DIY-Nabra/GrassiOsc-DIY/assets/mainboard_back.png

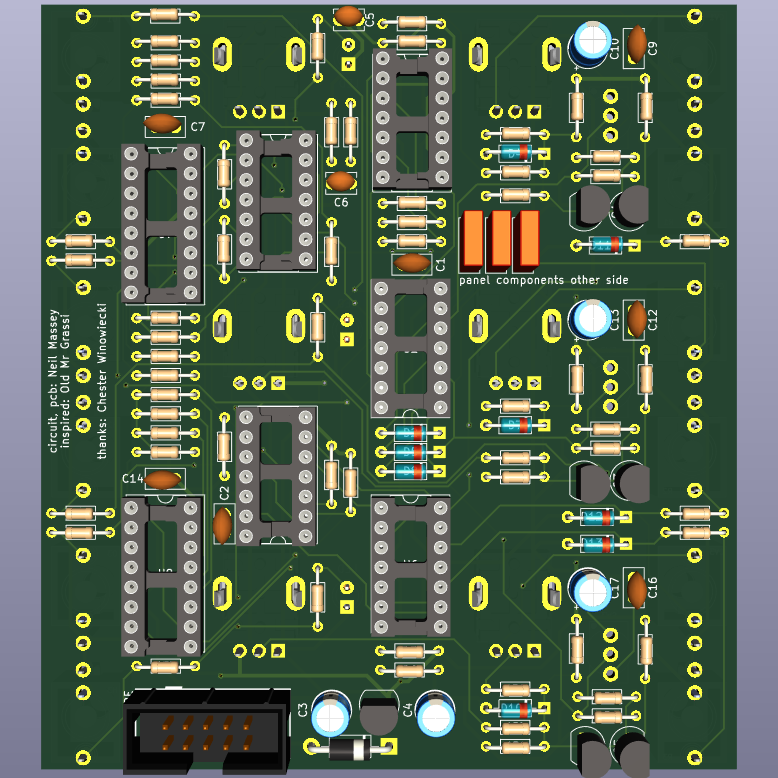
assets/mainboard_back.png
