DIY-Nabra/GrassiOsc-DIY/assets/alt-panel.png

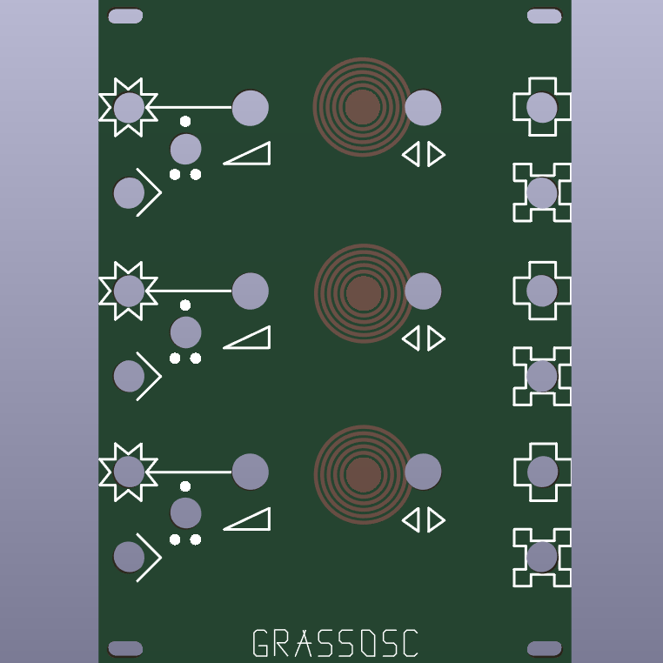
assets/alt-panel.png
