DIY-Nabra/GrassiOsc-DIY/assets/mainboard_front.png

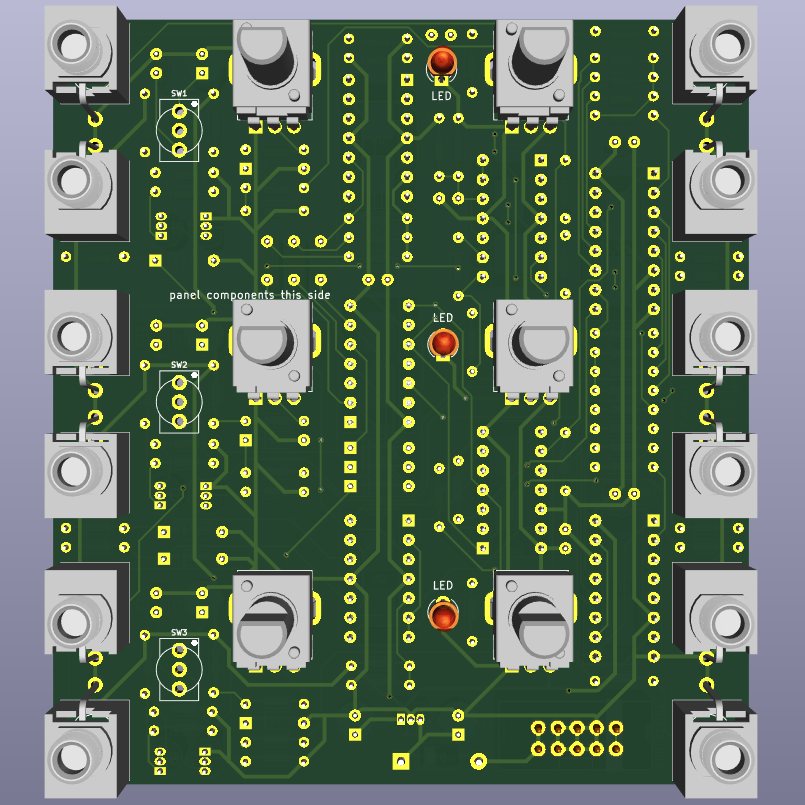
assets/mainboard_front.png
