DIY-Nabra/GrassiOsc-DIY/vector/mainboard-User_2.dxf

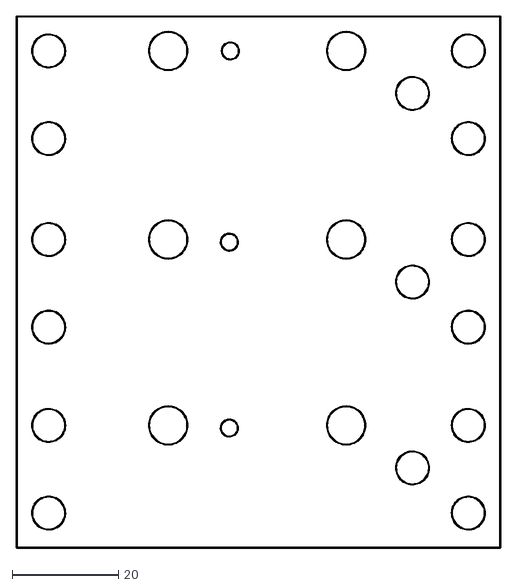
[picture p4: CAD file, 2022-08-26]
vector/mainboard-User_2.dxf
91.2 x 100.2
