DIY-Nabra/GrassiOsc-DIY/mainboard/mainboard.kicad_pcb

## KiCad design mainboard/mainboard.kicad_pcb (2022-09-11)

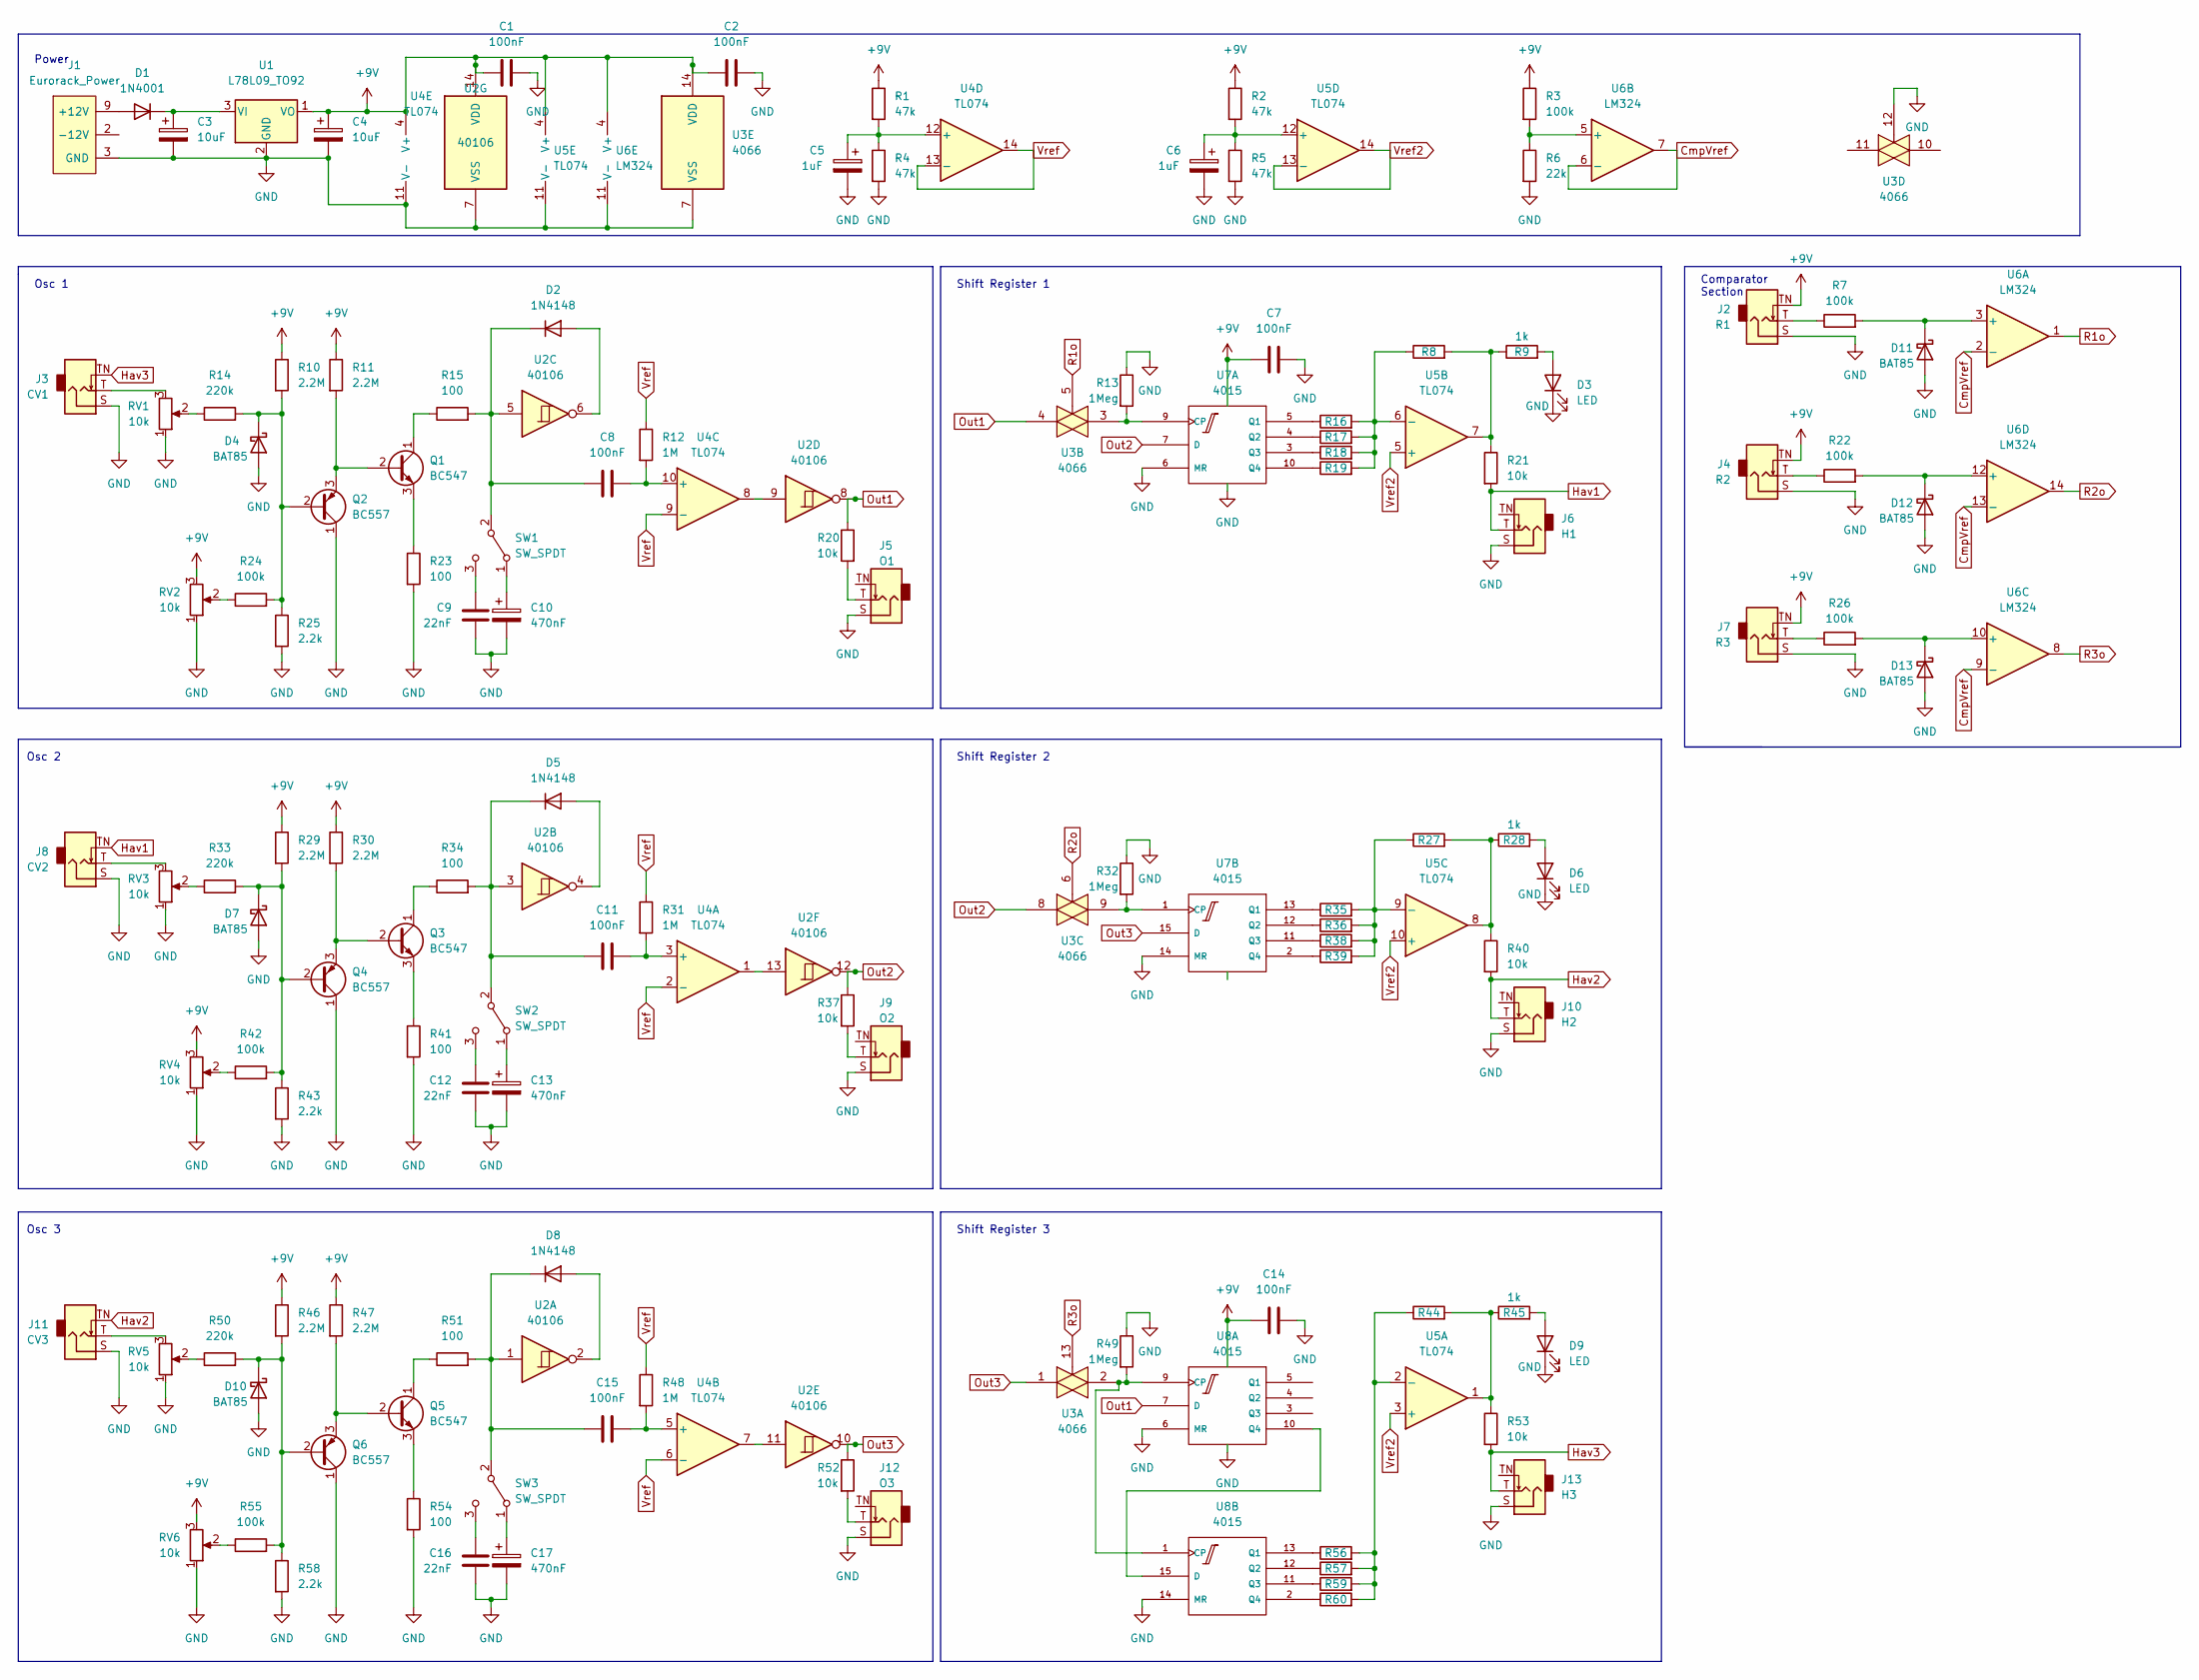
[picture p5: schematic mainboard.kicad_sch, GrassiOsc]

Parts:
C1, C2, C7, C14: 100nF; C_Disc_D5.0mm_W2.5mm_P2.50mm
C3, C4: 10uF; CP_Radial_D5.0mm_P2.50mm
C5, C6: 1uF; C_Disc_D3.8mm_W2.6mm_P2.50mm
C8, C11, C15: 100nF; C_Rect_L7.0mm_W2.5mm_P5.00mm
C9, C12, C16: 22nF; C_Disc_D5.0mm_W2.5mm_P2.50mm
C10, C13, C17: 470nF; CP_Radial_D5.0mm_P2.50mm
D1: 1N4001; D_DO-41_SOD81_P10.16mm_Horizontal
D2, D5, D8: 1N4148; D_DO-35_SOD27_P7.62mm_Horizontal
D3, D6, D9: LED; LED_D3.0mm
D4, D7, D10, D11, D12, D13: BAT85; D_DO-35_SOD27_P7.62mm_Horizontal
J1: Eurorack_Power; Eurorack_Power_2x5_Shrouded; mpn 302-S101
J2: R1; AudioJack_WQP518MA
J3: CV1; AudioJack_WQP518MA
J4: R2; AudioJack_WQP518MA
J5: O1; AudioJack_WQP518MA
J6: H1; AudioJack_WQP518MA
J7: R3; AudioJack_WQP518MA
J8: CV2; AudioJack_WQP518MA
J9: O2; AudioJack_WQP518MA
J10: H2; AudioJack_WQP518MA
J11: CV3; AudioJack_WQP518MA
J12: O3; AudioJack_WQP518MA
J13: H3; AudioJack_WQP518MA
Q1, Q3, Q5: BC547; TO-92_Inline
Q2, Q4, Q6: BC557; TO-92_Inline
R1, R2, R4, R5: 47k; R_Axial_DIN0204_L3.6mm_D1.6mm_P7.62mm_Horizontal
R3, R7, R22, R24, R26, R42, R55: 100k; R_Axial_DIN0204_L3.6mm_D1.6mm_P7.62mm_Horizontal
R6: 22k; R_Axial_DIN0204_L3.6mm_D1.6mm_P7.62mm_Horizontal
R8, R16, R17, R18, R19, R27, R35, R36, R38, R39, R44, R56, R57, R59, R60: R; R_Axial_DIN0204_L3.6mm_D1.6mm_P7.62mm_Horizontal
R9, R28, R45: 1k; R_Axial_DIN0204_L3.6mm_D1.6mm_P7.62mm_Horizontal
R10, R11, R29, R30, R46, R47: 2.2M; R_Axial_DIN0204_L3.6mm_D1.6mm_P7.62mm_Horizontal
R12, R31, R48: 1M; R_Axial_DIN0204_L3.6mm_D1.6mm_P7.62mm_Horizontal
R13, R32, R49: 1Meg; R_Axial_DIN0204_L3.6mm_D1.6mm_P7.62mm_Horizontal
R14, R33, R50: 220k; R_Axial_DIN0204_L3.6mm_D1.6mm_P7.62mm_Horizontal
R15, R23, R34, R41, R51, R54: 100; R_Axial_DIN0204_L3.6mm_D1.6mm_P7.62mm_Horizontal
R20, R21, R37, R40, R52, R53: 10k; R_Axial_DIN0204_L3.6mm_D1.6mm_P7.62mm_Horizontal
R25, R43, R58: 2.2k; R_Axial_DIN0204_L3.6mm_D1.6mm_P7.62mm_Horizontal
RV1, RV2, RV3, RV4, RV5, RV6: 10k; Potentiometer_Alpha_R0904N
SW1, SW2, SW3: SW_SPDT; Miniature_Switch_SPDT_2.54MM
U1: L78L09_TO92; TO-92_Inline
U2: 40106; DIP-14_W7.62mm_Socket
U3: 4066; DIP-14_W7.62mm_Socket
U4, U5: TL074; DIP-14_W7.62mm_Socket
U6: LM324; DIP-14_W7.62mm_Socket
U7, U8: 4015; DIP-16_W7.62mm_Socket

Connections:
+9V: C1.1, C2.1, C4.1, C7.1, C14.1, J2.TN, J4.TN, J7.TN, R1.1, R2.1, R3.1, R10.1, R11.1, R29.1, R30.1, R46.1, R47.1, RV2.3, RV4.3, RV6.3, U1.1 (VO), U2.14 (VDD), U3.14 (VDD), U4.4 (V+), U5.4 (V+), U6.4 (V+), U7.16 (Vdd), U8.16 (Vdd)
CmpVref: U6.2 (-), U6.6 (-), U6.7, U6.9 (-), U6.13 (-)
GND: C1.2, C2.2, C3.2, C4.2, C5.2, C6.2, C7.2, C9.1, C10.2, C12.1, C13.2, C14.2, C16.1, C17.2, D3.1 (K), D4.2 (A), D6.1 (K), D7.2 (A), D9.1 (K), D10.2 (A), D11.2 (A), D12.2 (A), D13.2 (A), J1.3 (GND), J1.4 (GND), J1.5 (GND), J1.6 (GND), J1.7 (GND), J1.8 (GND), J2.S, J3.S, J4.S, J5.S, J6.S, J7.S, J8.S, J9.S, J10.S, J11.S, J12.S, J13.S, Q2.1 (C), Q4.1 (C), Q6.1 (C), R4.2, R5.2, R6.2, R13.1, R23.2, R25.2, R32.1, R41.2, R43.2, R49.1, R54.2, R58.2, RV1.1, RV2.1, RV3.1, RV4.1, RV5.1, RV6.1, U1.2 (GND), U2.7 (VSS), U3.7 (VSS), U3.12, U4.11 (V-), U5.11 (V-), U6.11 (V-), U7.6 (MR), U7.8 (Vss), U7.14 (MR), U8.6 (MR), U8.8 (Vss), U8.14 (MR)
Hav1: J6.T, J8.TN, R21.2
Hav2: J10.T, J11.TN, R40.2
Hav3: J3.TN, J13.T, R53.2
unnamed: C3.1, D1.1 (K), U1.3 (VI)
unnamed: C5.1, R1.2, R4.1, U4.12 (+)
unnamed: C6.1, R2.2, R5.1, U5.12 (+)
unnamed: C8.1, D2.1 (K), R15.2, SW1.2 (B), U2.5
unnamed: C8.2, R12.2, U4.10 (+)
unnamed: C9.2, SW1.3 (C)
unnamed: C10.1, SW1.1 (A)
unnamed: C11.1, D5.1 (K), R34.2, SW2.2 (B), U2.3
unnamed: C11.2, R31.2, U4.3 (+)
unnamed: C12.2, SW2.3 (C)
unnamed: C13.1, SW2.1 (A)
unnamed: C15.1, D8.1 (K), R51.2, SW3.2 (B), U2.1
unnamed: C15.2, R48.2, U4.5 (+)
unnamed: C16.2, SW3.3 (C)
unnamed: C17.1, SW3.1 (A)
unnamed: D1.2 (A), J1.9 (+12V), J1.10 (+12V)
unnamed: D2.2 (A), U2.6
unnamed: D3.2 (A), R9.2
unnamed: D4.1 (K), Q2.2 (B), R10.2, R14.2, R24.2, R25.1
unnamed: D5.2 (A), U2.4
unnamed: D6.2 (A), R28.2
unnamed: D7.1 (K), Q4.2 (B), R29.2, R33.2, R42.2, R43.1
unnamed: D8.2 (A), U2.2
unnamed: D9.2 (A), R45.2
unnamed: D10.1 (K), Q6.2 (B), R46.2, R50.2, R55.2, R58.1
unnamed: D11.1 (K), R7.2, U6.3 (+)
unnamed: D12.1 (K), R22.2, U6.12 (+)
unnamed: D13.1 (K), R26.2, U6.10 (+)
unnamed: J1.1 (-12V), J1.2 (-12V)
unnamed: J2.T, R7.1
unnamed: J3.T, RV1.3
unnamed: J4.T, R22.1
unnamed: J5.T, R20.2
unnamed: J7.T, R26.1
unnamed: J8.T, RV3.3
unnamed: J9.T, R37.2
unnamed: J11.T, RV5.3
unnamed: J12.T, R52.2
unnamed: Q1.1 (C), R15.1
unnamed: Q1.2 (B), Q2.3 (E), R11.2
unnamed: Q1.3 (E), R23.1
unnamed: Q3.1 (C), R34.1
unnamed: Q3.2 (B), Q4.3 (E), R30.2
unnamed: Q3.3 (E), R41.1
unnamed: Q5.1 (C), R51.1
unnamed: Q5.2 (B), Q6.3 (E), R47.2
unnamed: Q5.3 (E), R54.1
unnamed: R3.2, R6.1, U6.5 (+)
unnamed: R13.2, U3.3, U7.9 (CP)
unnamed: R14.1, RV1.2
unnamed: R16.1, U7.5 (Q1)
unnamed: R8.1, R16.2, R17.2, R18.2, R19.2, U5.6 (-)
unnamed: R17.1, U7.4 (Q2)
unnamed: R18.1, U7.3 (Q3)
unnamed: R19.1, U7.10 (Q4)
unnamed: R8.2, R9.1, R21.1, U5.7
unnamed: R24.1, RV2.2
unnamed: R27.1, R35.2, R36.2, R38.2, R39.2, U5.9 (-)
unnamed: R27.2, R28.1, R40.1, U5.8
unnamed: R32.2, U3.9, U7.1 (CP)
unnamed: R33.1, RV3.2
unnamed: R35.1, U7.13 (Q1)
unnamed: R36.1, U7.12 (Q2)
unnamed: R38.1, U7.11 (Q3)
unnamed: R39.1, U7.2 (Q4)
unnamed: R42.1, RV4.2
unnamed: R44.1, R56.2, R57.2, R59.2, R60.2, U5.2 (-)
unnamed: R44.2, R45.1, R53.1, U5.1
unnamed: R49.2, U3.2, U8.1 (CP), U8.9 (CP)
unnamed: R50.1, RV5.2
unnamed: R55.1, RV6.2
unnamed: R56.1, U8.13 (Q1)
unnamed: R57.1, U8.12 (Q2)
unnamed: R59.1, U8.11 (Q3)
unnamed: R60.1, U8.2 (Q4)
unnamed: U2.9, U4.8
unnamed: U2.11, U4.7
unnamed: U2.13, U4.1
unnamed: U8.10 (Q4), U8.15 (D)
Out1: R20.1, U2.8, U3.4, U8.7 (D)
Out2: R37.1, U2.12, U3.8, U7.7 (D)
Out3: R52.1, U2.10, U3.1, U7.15 (D)
R1o: U3.5, U6.1
R2o: U3.6, U6.14
R3o: U3.13, U6.8
Vref: R12.1, R31.1, R48.1, U4.2 (-), U4.6 (-), U4.9 (-), U4.13 (-), U4.14
Vref2: U5.3 (+), U5.5 (+), U5.10 (+), U5.13 (-), U5.14

Notes on the sheet:
Osc 3
Shift Register 3
Osc 1
Shift Register 1
Osc 2
Shift Register 2
Comparator Section
Power

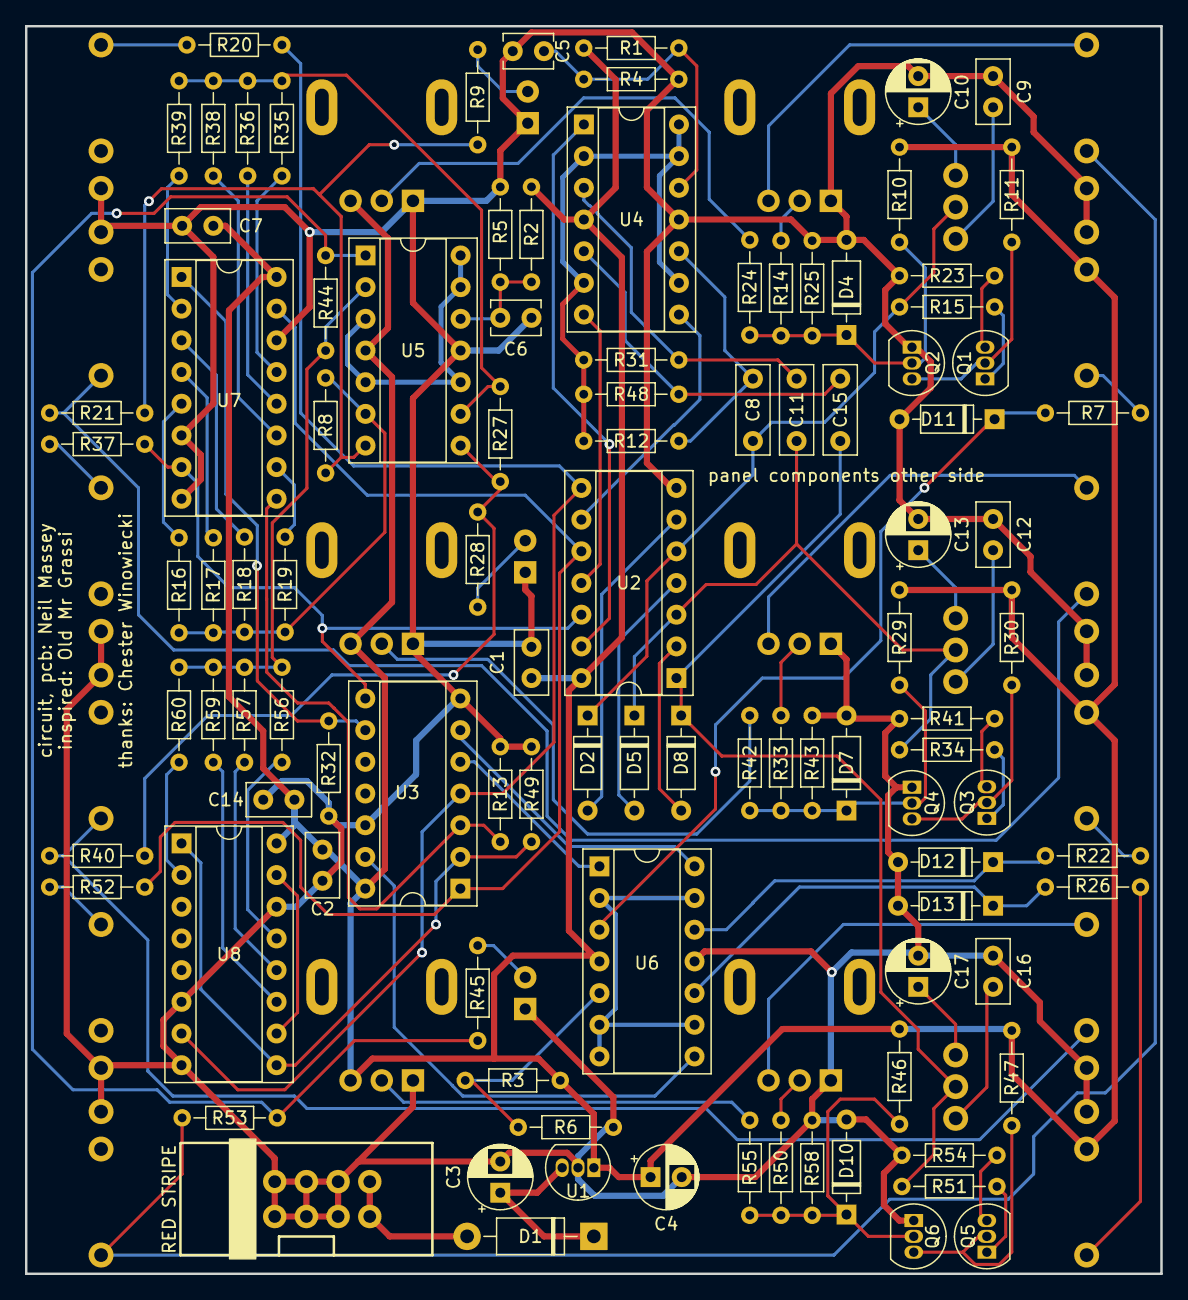
[picture p6: board mainboard.kicad_pcb from above]

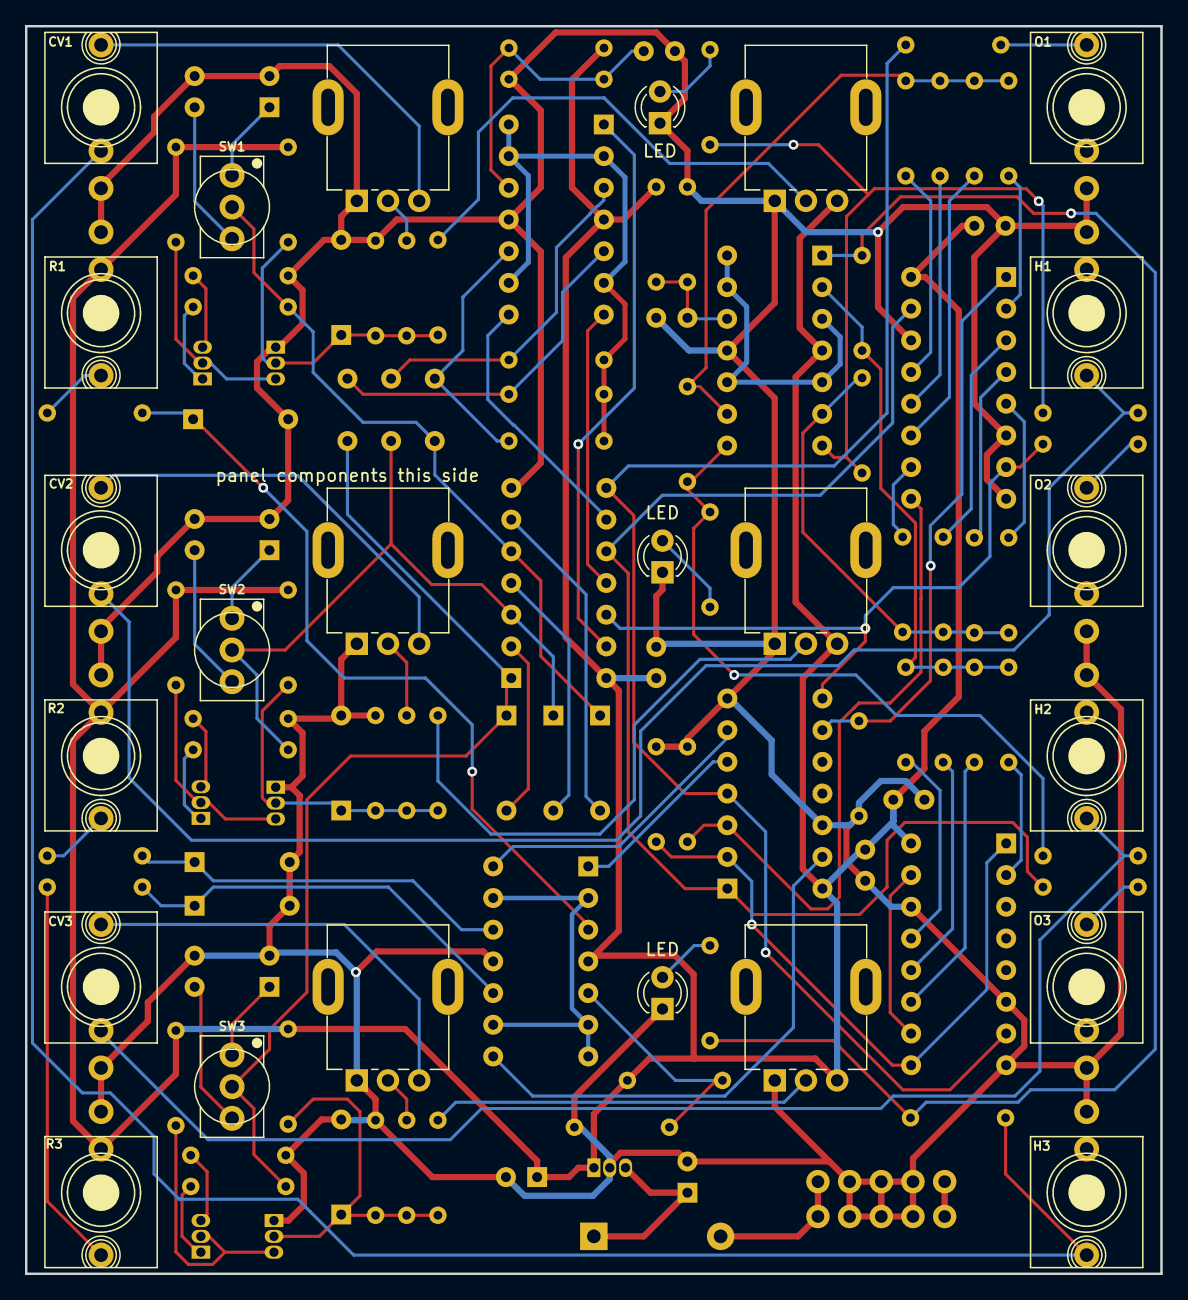
[picture p7: board mainboard.kicad_pcb from below]

Board: 2 copper layers, 91.0 x 100.0 mm, 126 parts (24 on the bottom side), 93 nets.
