DIY-Nabra/GrassiOsc-DIY/(commit log)

2022-08-03 First commit of panel
    [panel.kicad_pcb, panel.kicad_sch]
2022-08-04 Some more routing, moved D2, D5 and D8 to make it cleanr
    [mainboard.kicad_pcb, mainboard.kicad_sch]
2022-08-18 Panel commit
    [alt-panel.kicad_pcb, mainboard-User_2.dxf, mainboard.kicad_pcb, panel.kicad_pcb, panel.kicad_sch]
2022-08-25 Traces corrected
    [mainboard.kicad_pcb]
2022-08-26 Panel tweak
    [alt-panel.kicad_pcb]
2022-08-26 Panel tweaks
    [alt-panel.kicad_pcb, mainboard-User_2.dxf, mainboard.kicad_pcb]
2022-08-26 Added LICENSE
    [alt-panel.kicad_pcb, mainboard.kicad_pcb]
2022-08-26 Added BOM
2022-08-26 Amended BOM
2022-08-27 nologo panel and branch
    [alt-panel.kicad_pcb]
2022-09-03 updated BOM
2022-09-11 Rerouted: number of vias reduced from 39 to 13
    [mainboard.kicad_pcb, mainboard.kicad_sch]
